SkillSurf/ttsky25_se_opamp/assets/SS_process_corner-not_met.png

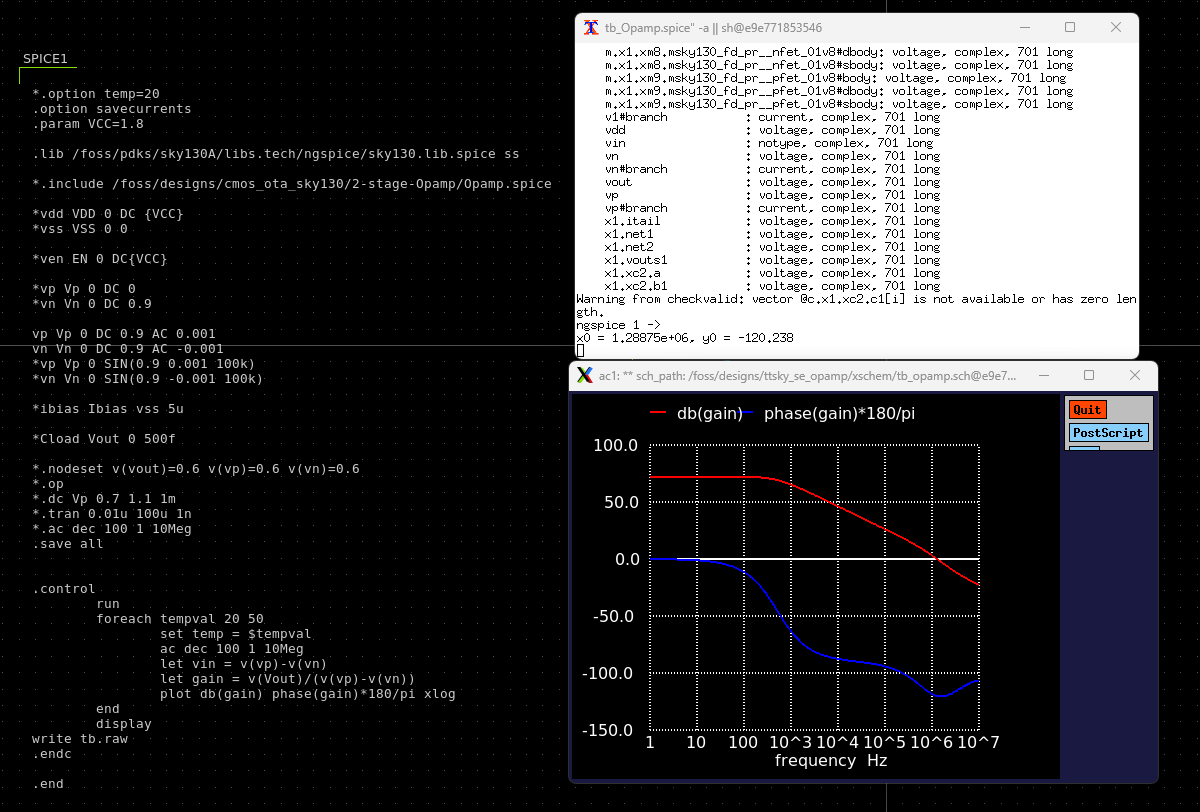
assets/SS_process_corner-not_met.png
