SkillSurf/ttsky25_se_opamp/assets/voltage-variations_1.7-1.9.png

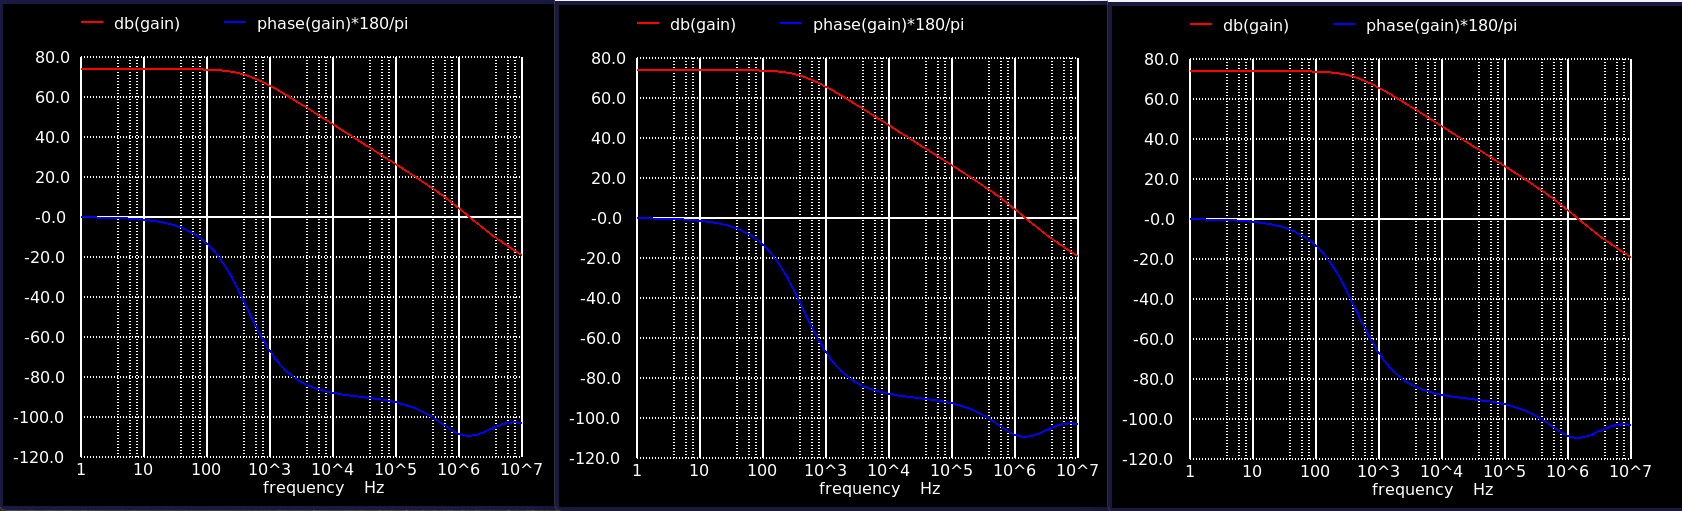
assets/voltage-variations_1.7-1.9.png
