SkillSurf/ttsky25_se_opamp/xschem/Opamp.spice

** sch_path: /foss/designs/ttsky_se_opamp/xschem/Opamp.sch
**.subckt Opamp VDD Vp Vn Vout Ibias VSS EN
*.ipin Vn
*.ipin Ibias
*.ipin Vp
*.ipin EN
*.opin Vout
*.iopin VSS
*.iopin VDD
XM2 Vouts1 Vp Itail GND sky130_fd_pr__nfet_01v8 L=1 W=4 nf=4 ad='int((nf+1)/2) * W/nf * 0.29' as='int((nf+2)/2) * W/nf * 0.29' pd='2*int((nf+1)/2) * (W/nf + 0.29)'
+ ps='2*int((nf+2)/2) * (W/nf + 0.29)' nrd='0.29 / W' nrs='0.29 / W' sa=0 sb=0 sd=0 mult=1 m=1
XM4 Vouts1 net1 VDD VDD sky130_fd_pr__pfet_01v8 L=1 W=4 nf=4 ad='int((nf+1)/2) * W/nf * 0.29' as='int((nf+2)/2) * W/nf * 0.29' pd='2*int((nf+1)/2) * (W/nf + 0.29)'
+ ps='2*int((nf+2)/2) * (W/nf + 0.29)' nrd='0.29 / W' nrs='0.29 / W' sa=0 sb=0 sd=0 mult=2 m=2
XM3 net1 net1 VDD VDD sky130_fd_pr__pfet_01v8 L=1 W=4 nf=4 ad='int((nf+1)/2) * W/nf * 0.29' as='int((nf+2)/2) * W/nf * 0.29' pd='2*int((nf+1)/2) * (W/nf + 0.29)'
+ ps='2*int((nf+2)/2) * (W/nf + 0.29)' nrd='0.29 / W' nrs='0.29 / W' sa=0 sb=0 sd=0 mult=2 m=2
XM1 net1 Vn Itail GND sky130_fd_pr__nfet_01v8 L=1 W=4 nf=4 ad='int((nf+1)/2) * W/nf * 0.29' as='int((nf+2)/2) * W/nf * 0.29' pd='2*int((nf+1)/2) * (W/nf + 0.29)'
+ ps='2*int((nf+2)/2) * (W/nf + 0.29)' nrd='0.29 / W' nrs='0.29 / W' sa=0 sb=0 sd=0 mult=1 m=1
XM6 Vout Vouts1 VDD VDD sky130_fd_pr__pfet_01v8 L=1 W=4 nf=4 ad='int((nf+1)/2) * W/nf * 0.29' as='int((nf+2)/2) * W/nf * 0.29' pd='2*int((nf+1)/2) * (W/nf + 0.29)'
+ ps='2*int((nf+2)/2) * (W/nf + 0.29)' nrd='0.29 / W' nrs='0.29 / W' sa=0 sb=0 sd=0 mult=7 m=7
XM5 Itail Ibias net4 VSS sky130_fd_pr__nfet_01v8 L=1 W=4 nf=4 ad='int((nf+1)/2) * W/nf * 0.29' as='int((nf+2)/2) * W/nf * 0.29' pd='2*int((nf+1)/2) * (W/nf + 0.29)'
+ ps='2*int((nf+2)/2) * (W/nf + 0.29)' nrd='0.29 / W' nrs='0.29 / W' sa=0 sb=0 sd=0 mult=8 m=8
XM7 Vout Ibias net3 VSS sky130_fd_pr__nfet_01v8 L=1 W=4 nf=4 ad='int((nf+1)/2) * W/nf * 0.29' as='int((nf+2)/2) * W/nf * 0.29' pd='2*int((nf+1)/2) * (W/nf + 0.29)'
+ ps='2*int((nf+2)/2) * (W/nf + 0.29)' nrd='0.29 / W' nrs='0.29 / W' sa=0 sb=0 sd=0 mult=11 m=11
XM8 Ibias Ibias net5 VSS sky130_fd_pr__nfet_01v8 L=1 W=4 nf=4 ad='int((nf+1)/2) * W/nf * 0.29' as='int((nf+2)/2) * W/nf * 0.29' pd='2*int((nf+1)/2) * (W/nf + 0.29)'
+ ps='2*int((nf+2)/2) * (W/nf + 0.29)' nrd='0.29 / W' nrs='0.29 / W' sa=0 sb=0 sd=0 mult=1 m=1
XC2 net2 Vout sky130_fd_pr__cap_mim_m3_1 W=30 L=75 MF=2 m=2
Rz net2 Vouts1 sky130_fd_pr__res_generic_l1 W=0.04 L=60 m=1
XM9 net4 EN VSS VSS sky130_fd_pr__nfet_01v8 L=1 W=4 nf=4 ad='int((nf+1)/2) * W/nf * 0.29' as='int((nf+2)/2) * W/nf * 0.29' pd='2*int((nf+1)/2) * (W/nf + 0.29)'
+ ps='2*int((nf+2)/2) * (W/nf + 0.29)' nrd='0.29 / W' nrs='0.29 / W' sa=0 sb=0 sd=0 mult=6 m=6
XM10 net3 EN VSS VSS sky130_fd_pr__nfet_01v8 L=1 W=4 nf=4 ad='int((nf+1)/2) * W/nf * 0.29' as='int((nf+2)/2) * W/nf * 0.29' pd='2*int((nf+1)/2) * (W/nf + 0.29)'
+ ps='2*int((nf+2)/2) * (W/nf + 0.29)' nrd='0.29 / W' nrs='0.29 / W' sa=0 sb=0 sd=0 mult=11 m=11
XM11 net5 EN VSS VSS sky130_fd_pr__nfet_01v8 L=1 W=4 nf=4 ad='int((nf+1)/2) * W/nf * 0.29' as='int((nf+2)/2) * W/nf * 0.29' pd='2*int((nf+1)/2) * (W/nf + 0.29)'
+ ps='2*int((nf+2)/2) * (W/nf + 0.29)' nrd='0.29 / W' nrs='0.29 / W' sa=0 sb=0 sd=0 mult=6 m=6
**** begin user architecture code
"Is Subcircuit" = YES
**** end user architecture code
**.ends
.GLOBAL GND
.end
