SkillSurf/ttsky25_se_opamp/assets/closed-loop-testbench.png

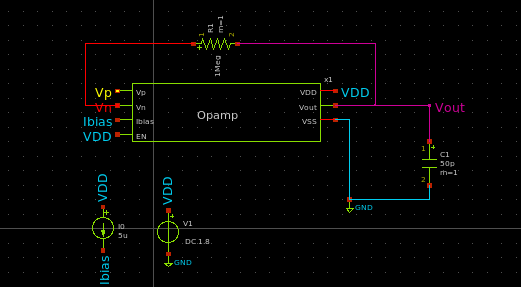
assets/closed-loop-testbench.png
