SkillSurf/ttsky25_se_opamp/(commit log)

2025-07-27 Adding the files
    [Opamp.sch, tb_Opamp.sch, tb_closed_loop.sch]
2025-07-31 layout read version
    [Opamp.sch, tb_Opamp.sch]
2025-08-08 Final working design
    [Opamp.sch, tb_Opamp_OP.sch, tb_Opamp_slewrate.sch, tb_Opamp_transient.sch, tb_Opamp_voltage_variation.sch, tb_closed_loop.sch]
2025-08-08 Adding switch to current mirror
    [Opamp.sch]
2025-08-10 Update README with Simulation results
    [tb_Opamp.sch, tb_closed_loop.sch]
2025-09-28 Layout for gain stages
2025-10-04 Layout for current mirror
